zibredlektab/stoplight/README.md

# stoplight
P-Tap voltage meter stoplight
