zibredlektab/stoplight/pcb/Stoplight.kicad_pcb

## KiCad design pcb/Stoplight.kicad_pcb (2025-09-24)

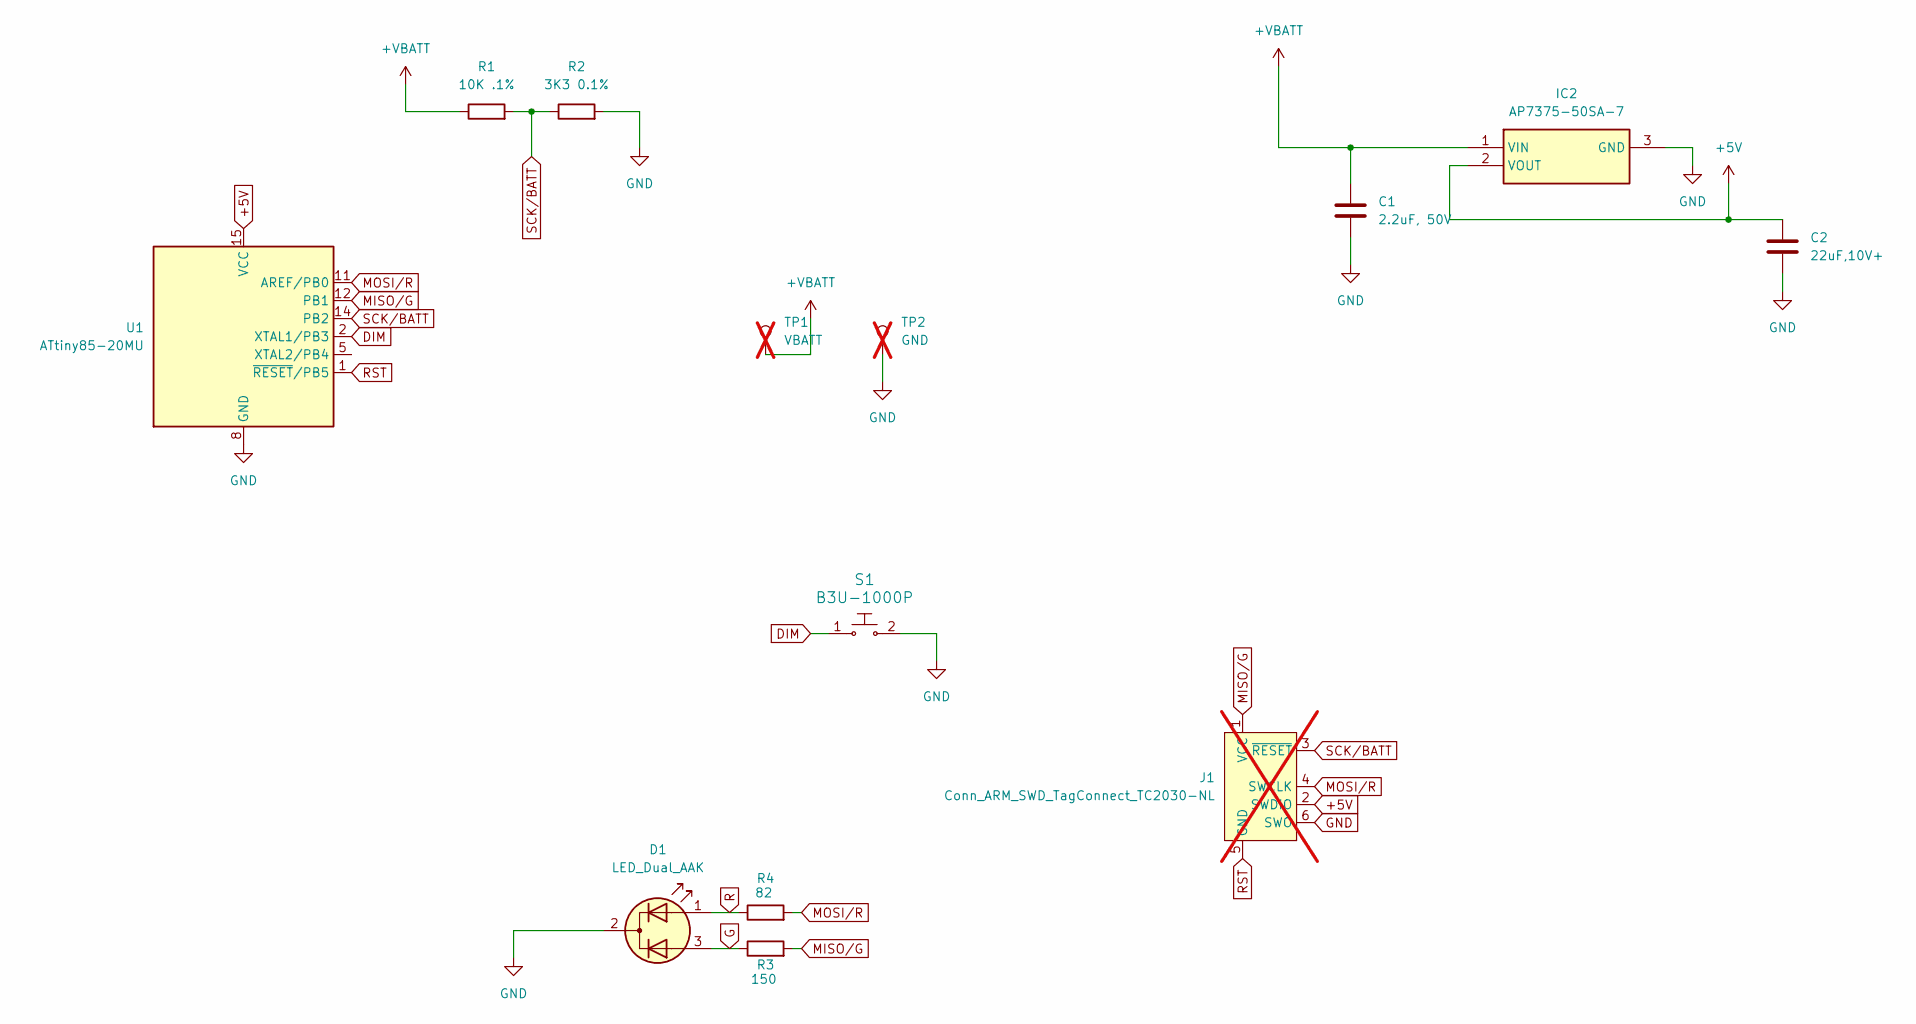
[picture p1: schematic Stoplight.kicad_sch]

Parts:
C1: 2.2uF, 50V; C_0603_1608Metric; Part Number GRM188R61H225KE11D
C2: 22uF,10V+; C_0402_1005Metric; Part Number GMC04X5R226M10NT
D1: LED_Dual_AAK; LED_D5.0mm-3; Part Number WP59SURKZGW
IC2: AP7375-50SA-7; TSOT-23; Part Number AP7375-50SA-7
J1: Conn_ARM_SWD_TagConnect_TC2030-NL; Tag-Connect_TC2030-IDC-NL_2x03_P1.27mm_Vertical; not fitted
R1: 10K .1%; R_0402_1005Metric; Part Number 4-2176755-8
R2: 3K3 0.1%; R_0402_1005Metric; Part Number TNPW04023K30BEED
R3: 150; R_0402_1005Metric; Part Number ERJ-PA2F1500X
R4: 82; R_0402_1005Metric; Part Number ERJ-PA2F82R0X
S1: B3U-1000P; Switch_Tactile_SMD_B3U-1000P; Part Number B3U-1000P
TP1: VBATT; TestPoint_Pad_2.0x2.0mm; not fitted
TP2: GND; TestPoint_Pad_2.0x2.0mm; not fitted
U1: ATtiny85-20MU; QFN-20-1EP_4x4mm_P0.5mm_EP2.6x2.6mm; Part Number ATTINY85-20MU

Connections:
+5V: C2.2, IC2.2 (VOUT), J1.2 (SWDIO), U1.15 (VCC)
+VBATT: C1.2, IC2.1 (VIN), R1.1, TP1.1
DIM: S1.1, U1.2 (XTAL1/PB3)
G: D1.3 (A2), R3.1
GND: C1.1, C2.1, D1.2 (K), IC2.3 (GND), J1.6 (SWO), R2.2, S1.2, TP2.1, U1.8 (GND), U1.21 (GND)
MISO/G: J1.1 (VCC), R3.2, U1.12 (PB1)
MOSI/R: J1.4 (SWCLK), R4.2, U1.11 (AREF/PB0)
R: D1.1 (A1), R4.1
RST: J1.5 (GND), U1.1 (~RESET/PB5)
SCK/BATT: J1.3 (~RESET), R1.2, R2.1, U1.14 (PB2)

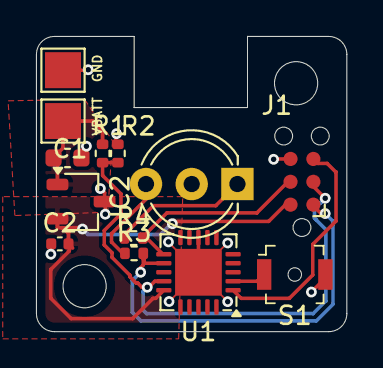
[picture p2: board Stoplight.kicad_pcb from above]

Board: 2 copper layers, 17.2 x 16.4 mm, 13 parts (0 on the bottom side), 10 nets.
