zibredlektab/stoplight/(commit log)

2025-03-02 initial pcb work
    [Stoplight.kicad_pcb, Stoplight.kicad_sch]
2025-03-03 Good double-sided design
    [Stoplight.kicad_pcb, Stoplight.kicad_sch]
2025-03-03 Tested on breadboard, working
    calibrated voltage levels
    [Stoplight.kicad_pcb]
2025-03-04 Another solid design, but going to try for even simpler
    [Stoplight.kicad_pcb, Stoplight.kicad_sch]
2025-03-04 Almost entirely single-layer now
    [Stoplight.kicad_pcb, Stoplight.kicad_sch]
2025-03-06 Added hysteresis for increasing voltage levels, pretty solid now
2025-03-06 some rearranging
    [Stoplight.kicad_pcb]
2025-03-11 Swapped mcu package to SOIC-8 for easier soldering
    [Stoplight.kicad_pcb, Stoplight.kicad_sch]
2025-03-11 Code now properly calculates voltage from ADC
2025-03-18 Ordered v1, updated part numbers to reflect availability
    [Stoplight.kicad_pcb, Stoplight.kicad_sch]
2025-08-26 pcb v1a
    [Stoplight.kicad_pcb, Stoplight.kicad_sch]
2025-09-15 Replaced dimmer with dim button. Currently functional
    [stoplight.ino]
2025-09-16 redesigning pcb to be smaller & use tag-connect
    [Stoplight.kicad_pcb, Stoplight.kicad_sch]
2025-09-16 pcb v1b, ready to manufacture
    [Stoplight.kicad_pcb, Stoplight.kicad_sch]
2025-09-24 v1b PCB as ordered
    [Stoplight.kicad_pcb, Stoplight.kicad_sch]
2026-04-10 Updated code to reflect wiring changes in v1b
